ricciolino/smartintercom-OV7670/README.md

# smartintercom-OV7670
IoT project in Smart Home environment: prototype of a smart intercom.
