ricciolino/smartintercom-OV7670/relazione.pdf

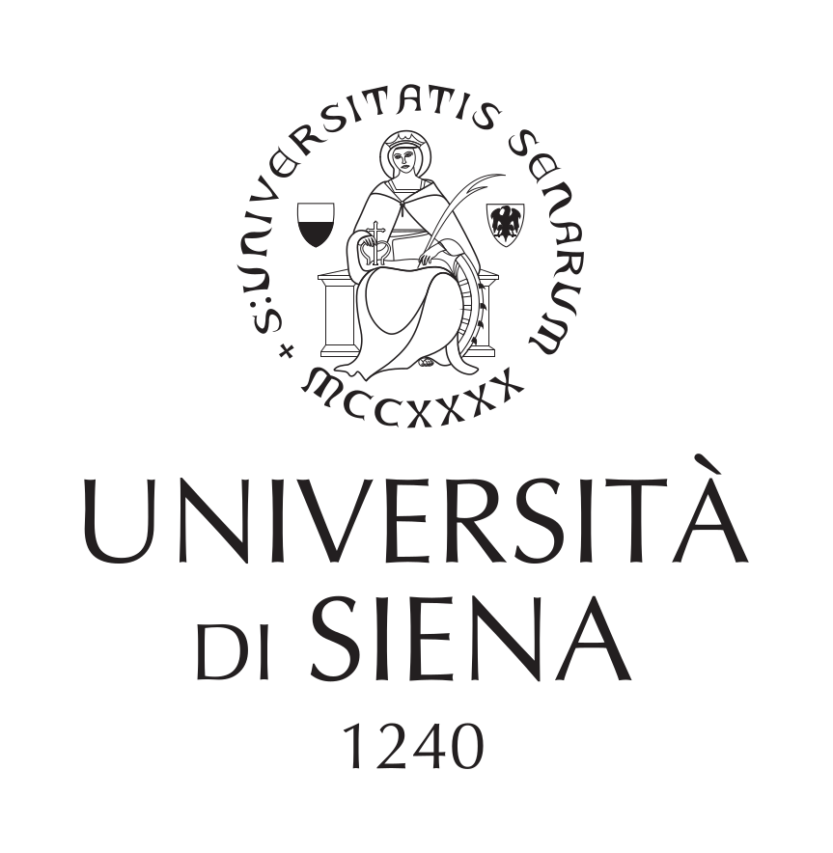
[picture p1: figure]

# Dipartimento di Ingegneria dell’Informazione e Scienze Matematiche

# progetto d’esame:

# Laboratorio di Internet of Things

# CITOFONO CON CAMERA OV7670 ED ESP8266

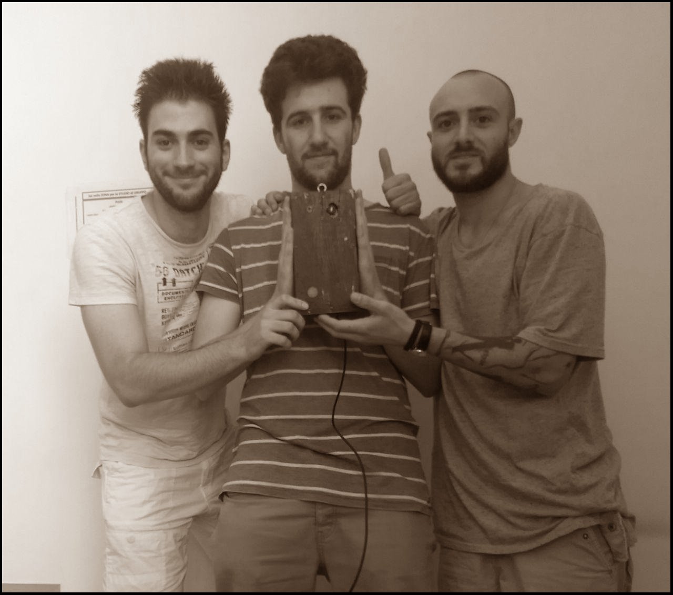
[picture p2: figure]

# A cura di: Lorenzo Moricone, Giovanni Fasino e Nicholas Redi

# lorenzo.moricone@student.unisi.it , gfasino@gmail.com , nicholasredimail@gmail.com

# Anno Accademico 2018-2019

# Indice

- Introduzione | [2]
- Hardware e software utilizzato | [3]
- OV7670 con Arduino UNO | [4]
– Connettere i pezzi | [5]
∗ XCLK | [5]
∗ SIOC e SIOD | [6]
∗ VSYNC, HREF e PCLK | [6]
∗ LED e BOTTONE | [7]
– Lo sketch | [7]

# - ESP8266: comunicazione

seriale ed invio al server | [9]
- Server locale e PHP | [12]
– Channel e BOT Telegram | [12]
– sendphoto.php | [13]
- Conclusioni e possibili sviluppi | [14]
- Codici | [14]
– Arduino UNO | [15]
– ov7670.h | [17]
– ESP8266 | [22]
– initphoto.php | [24]
– dato.php | [24]
– sendphotoAus.php | [25]
– sendphoto.php | [25]
- MEME moments | [26]

1

# Introduzione

# Nel realizzare un progetto IoT in un ambiente Smart Home `e stato deciso di fare un prototipo di un citofono intelligente. Quest’oggetto ha un’applica-

zione abbastanza semplice nel mondo reale quanto utile.

# L’idea di base `e la seguente: la funzione del citofono smart la si attiva quando non si `e in casa, in questo modo qualora qualcuno prema il bottone per suonare il citofono, una fotocamera connessa ad un Arduino gli scatter`a una

foto, che verr`a inviata ad un server locale tramite un modulo Wi-Fi.

# Lato server poi, attraverso le API Telegram disponibili per PHP, si azioner`a un BOT che inoltrer`a la foto su un canale di telegram; gli utenti iscritti a questo canale potranno quindi essere notificati (come per un qualsiasi mes-

saggio) e vedere la foto scattata dal proprio smartphone.

# L’utilit`a dell’oggetto risiede nel fatto di poter sapere da chi siamo cercati

mentre non siamo in casa.

2

# Hardware e software utilizzato

# L’hardware utilizzato per la prototipazione di questo oggetto `e composto da i seguenti elementi:

# - Jumpers

- Breadboard | x1
- Arduino UNO | x1
- ESP8266 | x1
- Camera OV7670 (no FIFO) | x1
- Bottone | x1
- Led | x1
- Resistore 10 kΩ | x2
- Resistore 4.7 kΩ | x2
- Resistore 8.2 kΩ | x1
- Resistore 220 Ω | x1

# Mentre per la parte software `e necessario avere installato e configurato i seguenti servizi¹

:

# - Arduino IDE

# - Apache

# - php

# - php-curl

# 1nota: per la realizzazione dell’intero progetto si suppone di lavorare in ambienti Linux (altri ambienti `e possibile utilizzarli con le dovute accortezze)

| 3

# OV7670 con Arduino UNO

# La prima fase della progettazione riguarda la connessione della camera

con l’Arduino, affinch`e essa sia in grado di trasmettere i dati alla porta sriale.

# Il chip OV7670 `e composto da 18 pin, prevede una tensione di alimentazione di 3.3 V e comunica attraverso il protocollo seriale SCCB (Serial Camera Control Bus), un protocollo seriale proprietario di OmniVision Technologies

Inc. che `e basato sul protollo I2C.
In figura 1 e 2 sono mostrati il chip e la relativa descrizione dei pin.

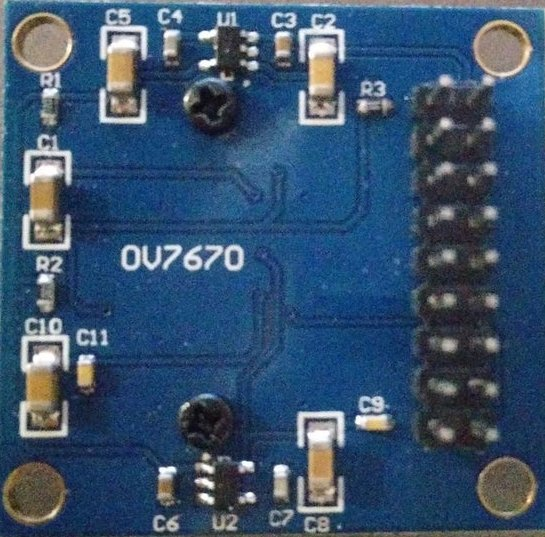
[picture p3: figure]

Figura 1: OV7670 chip.

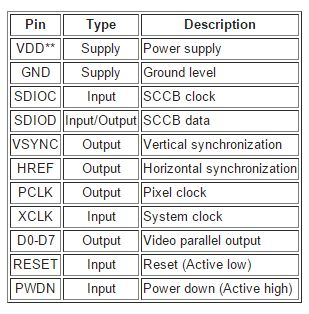
[picture p4: figure]

Figura 2: OV7670 pins description.

Per questo primo interfacciamento si pu`o sfruttare un precedente lavoro² pubblicato da ”ComputerNerd”. Grazie ad esso `e possibile collegare il modulo OV7670 ad Arduino UNO con uno schema ben preciso, ed andare programmare il microcontrollore ATmega328 di Arduino servendosi di una libreria sviluppata ad-hoc. In particolare, tale libreria permette di resettare e impostare (in accordo al datasheet³ ) i registri della fotocamera per acquisire

# 2https://github.com/ComputerNerd/ov7670-no-ram-arduino-uno 3https://www.voti.nl/docs/OV7670.pdf

4

# immagini con risoluzione QVGA (320x240) e codifica del colore YUV422 (in

scala di grigi a 8 bit).

# Connettere i pezzi

Lo schematico prevede i collegamenti mostrati in figura 3.

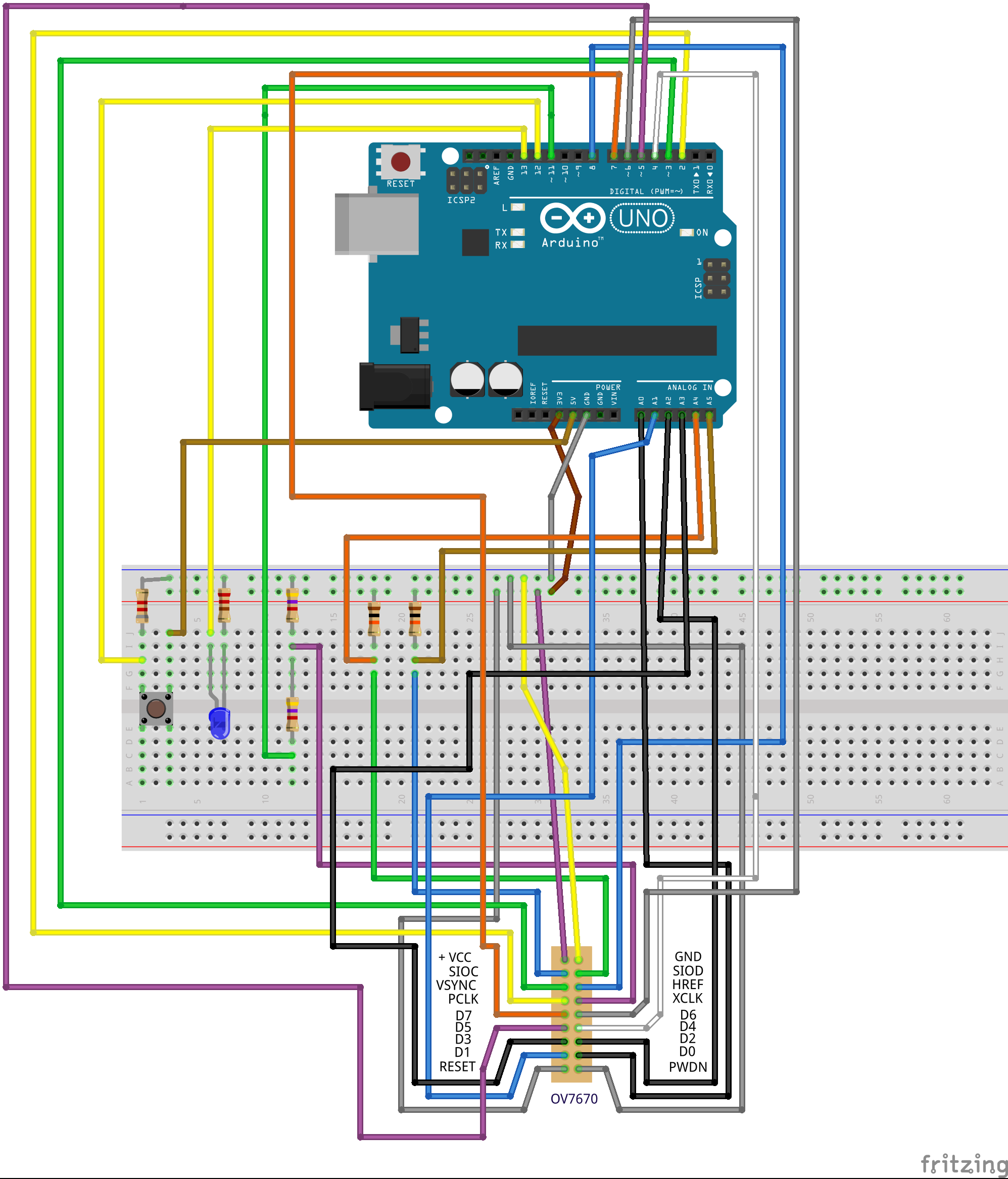
[picture p5: figure]

Figura 3: Connettere Arduino UNO alla fotocamera OV7670.

# XCLK

# Il modulo fotocamera richiede in ingresso un clock di sistema sul pin XCLK. Questo clock `e essenziale per il funzionamento dell’interfaccia SCCB e per qualsiasi altra operazione della fotocamera. Secondo il datasheet, la frequenza su XCLK dovrebbe essere compresa tra 10 e 48 MHz, tuttavia la

5

camera funziona correttamente anche con un clock a 8 MHz.

# Infatti, in questa configurazione, tale clock `e generato con un segnale PWM da 8 MHz dal pin D11 dell’Arduino e, poich`e il chip non sopporta voltaggi superiori ai 3.3 V, `e stato inserito un partitore di tensione per assicurarsi che

il voltaggio in ingresso al modulo OV7670 non superi i 3 V.

# SIOC e SIOD

# Ogni comunicazione seriale I2C `e costituita da due segnali: SCL (Serial Clock) e SDA (Serial Data). Per la fotocamera questi ruoli sono ricoperti

rispettivamente dai pin SIOC e SIOD.

Dato che Arduino lavora a 5 V mentre il modulo OV7670 lavora a 3.3 V, per rendere possibile la comunicazione I2C c’`e bisogno di due resistori di pull-up sul pi`u basso dei due voltaggi (3.3 V). In questa maniera, quando non sono attive le linee SCL e SDA (attive basse), il minimo livello di tensione che ci potr`a essere sar`a 3.3 V, livello che Arduino riconoscer`a come HIGH (e quindi

non attiver`a la linea).

# VSYNC, HREF e PCLK

Il chip invia i dati in un formato sincrono parallelo. Dopo che `e stato applicato un segnale di clock al pin XCLK, la fotocamera inizier`a a pilotare i suoi pin VSYNC, HREF e D0-D7. Il fronte di discesa di VSYNC segnala l’inizio di un frame e il suo fronte di salita segnala la fine. Ogni frame QVGA ha 240 righe e ogni riga ha 320 pixel. Ogni dato di riga deve essere catturato durante lo stato alto di HREF, cio`e D0-D7 devono essere campionati solo quando HREF `e alto. Il fronte di salita di HREF segnala l’inizio di una riga

e il fronte di discesa di HREF segna la fine.
In fugura 4 `e mostrata la temporizzazione.

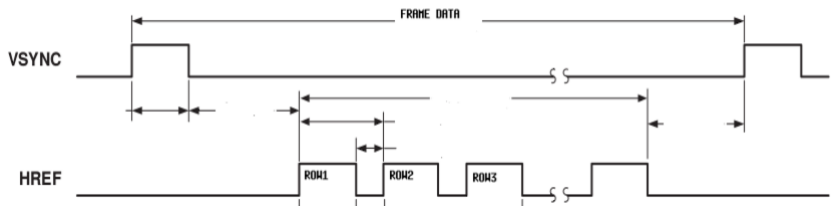
[picture p6: figure]

Figura 4: Temporizzazione durante l’acquisizione di un frame.

# In particolare, D0-D7 devono essere campionati sul fronte di salita del segnale PCLK. La frequenza del segnale PCLK determiner`a quindi, quanto

6

# velocemente vengono acquisiti i byte di una riga (di default PCLK avr`a la

stessa frequenza di XCLK).
In figura 5 sono mostrate le tempistiche da rispettare.

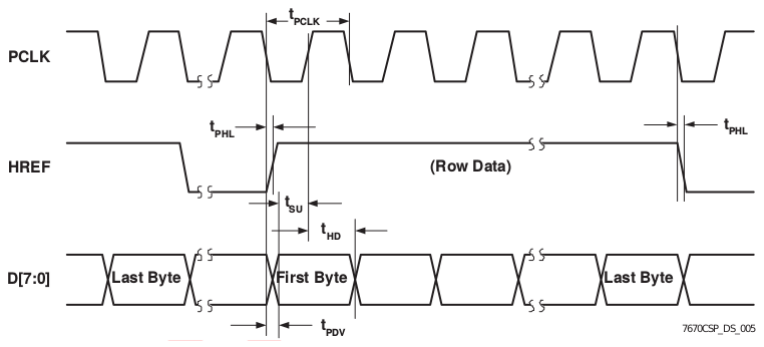
[picture p7: figure]

Figura 5: Temporizzazione durante l’acquisizione di una riga.

# LED e BOTTONE

La logica che sta dietro il led ed il bottone `e molto semplice.

# Il bottone simula il tasto per suonare il citofono, quindi la camera inizier`a

l’acquisizione di un’immagine solo dopo che esso `e stato premuto.

# Il led, invece, lo si pu`o interpretare come un debug visivo: quando il bottone viene schiacciato, il led star`a acceso per 3 secondi, seguir`a un cortissimo blink e torner`a di nuovo acceso, questo segnala l’inizio dell’acquisizione effet-

tiva dell’immagine; per tutto il tempo di acquisizione il led rimarr`a acceso,

# dopodich`e si spenger`a; circa 4 secondi dopo che l’acquisizione `e terminata ci sar`a un cortissimo blink che segnaler`a la possibilit`a di acquisire una nuova

immagine.

# Lo sketch

# Per quanto riguarda la programmazione del microcontrollore ATmega328 `e sufficiente fare l’upload, tramite la IDE Arduino, dello sketch a pagina

14.

# Si pu`o notare come nello sketch `e incluso il file di libreria ”ov7670.h” (il cui codice `e a pagina 16), necessario per l’impostazione di tutti i registri della

fotocamera.

7

# Analizzando il codice dello sketch secondo la logica di Arduino, in fase di setup() si hanno 4 chiamate a funzioni con le seguenti funzionalit`a:

# - arduinoUnoInit() : imposta il segnale di clock per XLCK sul pin 11, imposta la comunicazione con protocollo I2C a 100 kHz ed abilita

la porta seriale con baud rate 1Mbps;

- camInit() : reimposta ai valori predefiniti tutti i registri del chip;
- setRes() : imposta la risoluzione con la quale acquisire l’immagine;
- setColor() : imposta la codifica dei colori;

# successivamente, vengono definiti gli usi dei pin 12 e 13 (rispettivamente per il bottone, INPUT, e per il led, OUTPUT); ed infine si ha un cortissimo blink del led, per segnalare che la fase di setup `e terminata e che la fotocamera `e

pronta per acquisire un’immagine.

Nel loop(), semplicemnete, si usano due variabili (lettura ed old lettura) per controllare lo stato di pressione del pulsante, ed una volta che esso viene premuto, dopo esserci stati i blink descritti prima, si invoca la funzione captureImg(), la quale si occupa della logica di acquisizione dell’immagi-

ne.

La logica di acquisizione funziona cos`ı: viene inviata una sequenza di 5 caratteri ’*’,’R’,’D’,’Y’,’*’ che rappresenta il comando con il quale l’ESP8266 sar`a in grado di sapere qual’`e il primo byte che dovr`a memorizzare come dato dell’immagine, e poi si inizia a ”ciclare” su 240 righe e 320 colonne con le tempistiche definite da VSYNC, HREF e PCLK. I byte da trasmettere alla porta seriale sono preparati sul registro di Arduino UDR0, e

poi trasmessi non appena passa il segnale PCLK.

La cosa di rilievo per questa applicazione, `e che, siccome l’ESP8266 ha una quantit`a di RAM utilizzabile che non supera i 50 kB, si deve effettuare un ritaglio dell’immagine, ottenendo un’immagine 160x120. Utilizzando un byte per pixel (scala di grigio da 0 a 255), si avrebbe un peso dell’immagine in formato QVGA pari a 320 · 240 bytes = 76800 kB e di conseguenza l’ESP non potrebbe ospitarla per intero prima di inviarla, dopo un ritaglio centrale di 160x120 l’immagine peser`a 160 · 120 bytes = 19200 kB, cos`ı l’ESP sar`a in grado di mantenerla in RAM e spezzettarla in pi`u pacchetti per poi inviarla

al server.

8

# ESP8266: comunicazione seriale ed invio al server

# Dopo che l’Arduino `e in grado di acquisire l’immagine e di trasmetterla alla porta seriale correttamente, quello che si deve fare `e collegare il pin TX

di Arduino al pin RX del chip ESP8266.
In figura 6 `e mostrato lo schematico finale.

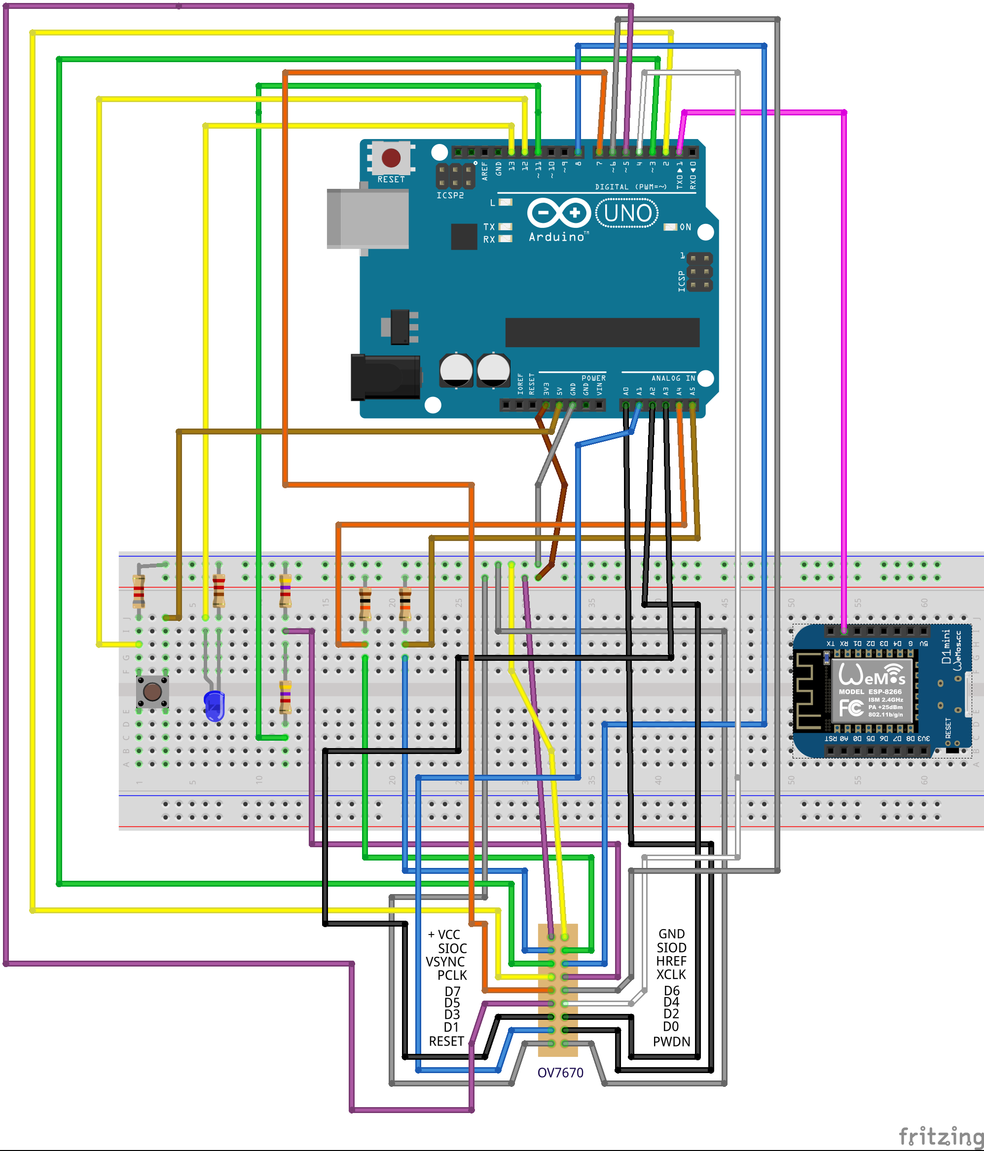
[picture p8: figure]

Figura 6: Schema finale.

# Cos`ı facendo, Arduino UNO abiliter`a la porta seriale in trasmissione verso

l’ESP e, ricordando che il baud rate `e stato impostato da Arduino a 1Mbps,

9

# la comunicazione seriale da attivare lato ESP, dovr`a essere inizializzata alla

stessa frequenza.
Il codice dello sketch per l’ESP `e a pagina 21.

# Nel setup() viene inizializzata la comunicazione seriale a 1 Mbps e creato

l’oggetto WiFiMulti per la connessione alla rete WiFi.

# Nel loop() non si proceder`a oltre il primo controllo, finch`e il modulo ESP non risulter`a connesso alla rete (pu`o richiedere alcuni secondi). Una volta connesso, l’ESP inizier`a a controllare se ci sono dati in arrivo sulla porta se-

riale, cercando di rilevare la sequenza di comando ’*’,’R’,’D’,’Y’,’*’.

Quando sono stati letti i 5 bytes consecutivamente, la variabile photoStarted diventer`a true, e da quel momento, ogni altro byte in arrivo alla seriale sar`a un byte che rappresenta un pixel dell’immagine. E’ importante che i bytes dell’immagine siano letti dall’ESP il pi`u velocemente possibile, cio`e non sono ammesse molte altre operazioni ”fattibili” dall’ESP mentre questo sta leg-

gendo in sequenza i bytes, questo perch`e, essendo il baud rate molto elevato,

ogni altra operazione che farebbe ”perdere tempo” all’ESP rischia di essere abbastanza lunga da far intasare il buffer di comunicazione seriale; ci`o provocherebbe problemi di sincronia tra i due dispositivi e non sarebbe possibile acquisire tutti i bytes dell’immagine correttamente. Inoltre, c’`e da dire che `e proprio questo il motivo per cui l’immagine va ritagliata fino a farla entrare nella RAM dell’ESP: si potrebbe pensare di inviare l’immagine a pezzetti proprio nel mentre si stanno acquisendo i dati dall’Arduino, il fatto `e, che inviare i dati sul web `e un operazione time-consuming, la sincronizzazione sarebbe compromessa. E’ quindi fondamentale riuscere a salvare completa-

mente l’immagine prima di inviarla a pezzetti.

Mentre si acquisiscono i dati dell’immagine, si pu`o notare nel codice, che alcuni livelli di grigio acquisiti dalla fotocamera, vengono manipolati (incrimentati di 1 o di 2); questo `e necessario affinch`e, nell’invio dei pacchetti al server, la stringa che si costruisce come dato del protocollo POST, non sia tagliata involontariamente. Per cui, quando il livello di grigio `e pari a uno dei valori tra 0, 9, 10, 13, 37 e 38 si cambier`a il valore di 1 (2 nel caso di

9 e 37) e la stringa che rappresenter`a il dato del pacchetto da trasmettere,

# non creer`a problemi. Tanto 1 o 2 punti di differenza, in una scala di grigio tra 0 e 255, e, per altro solo in alcuni pixels, non distorceranno la visibilit`a

dell’immagine ad occhio nudo.

Quando il buffer dei dati dell’immagine sar`a riempito ( i == BUFFER SIZE == 19200 ), e quindi l’immagine `e in quel momento salvata comletamente in RAM (in formato grezzo), si passer`a all’invio di essa tramite richieste http al server locale ( http://localhost/PHPIoT/ ). Viene diviso il buffer in sotto-buffer di 2400 bytes e inviati 8 pacchetti con il dato incapsulato sotto forma di stringa. Le operazioni in sequenza, eseguite dal momento che

10

# l’immagine `e salvata, sono le seguenti:

# 1. pulizia del file img.txt (memorizzato nel server) in caso di foto pre-

cedentemente acquisita: chiamata GET al file initphoto.php ;

# 2. invio degli 8 pacchetti da 2400 bytes, appendendoli uno dietro l’altro

al file img.txt, tramite richieste http POST al file dato.php ;

# 3. concatenazione dell’header BMP ( head160x120.bmp ) al file grezzo img.txt per costruire l’immagine finale (apribile con un visualizzatore di foto), ed invio dell’immagine sul canale Telegram: chiamata GET al

file sendphotoAus.php .

Successivamente a queste tre fasi, l’ESP viene resettato per assicurarsi che l’acquisizione di foto successive non occupi tutte le aree di memoria disponibili. Con il reset, i buffer vengono riallocati nuovamente, ed almeno un’acquisizione potr`a sempre andare a buon fine. Il delay() di 4 secondi alla fine del loop() di Arduino UNO `e dovuto proprio a questo tempo, necessario

per l’ESP a resettarsi.

11

# Server locale e PHP

# I codici PHP utilizzati dal server sono visibili tutti nella sezione ”Codici”

a partire da pagina 24.

# Come gi`a detto, la fase di invio dell’ESP si pu`o suddividere in 3 diverse fasi:

la prima fase, riguarda la pulizia del file che deve contenere i dati della foto;

# nella seconda fase, ricorrono pi`u chiamate ad uno stesso file che si occupa di costruire il file dell’immagine grezza; e la terza fase, in cui si costruisce

l’immagine finale e poi la si invia sul canale Telegram.

# La pulizia del file avviene nel file initphoto.php, semplicemente eseguendo da PHP un comando di sistema Linux: se il file img.txt esiste, viene

svuotato (se `e pieno), altrimenti viene creato vuoto.

# Nel file dato.php si estrapola il dato dal metodo POST, ci si assicura che

il file img.txt esista e sia scrivibile, e poi gli si appende la stringa di bytes.

Il file sendphotoAus.php `e solamente un file ausiliario che, tramite un comando di sistema, semplicemente richiama il file sendphoto.php. Questo `e dovuto a ragioni di sicurezza, in quanto `e necessario che il file che si occuper`a di sfruttare le API Telegram per inviare la foto, dovr`a essere chiamato

dal server stesso, e non da fonti esterne.

# Channel e BOT Telegram

# Prima di descrivere il file sendphoto.php `e necessario spiegare cosa va

fatto dall’account Telegram per essere in grado di utilizzare le API in PHP.

# Il primo passo `e quello di creare un BOT sfruttando un’altro BOT messo a disposizione da Telegram con lo username @BotFather. Seguendo le istruzioni di questo BOT sar`a possibile creare un proprio BOT personale. Con la creazione, @BotFather ci fornir`a ache il token del BOT da utilizzare con

le API http.

Poi bisogner`a creare un canale (pubblico) ed aggiungere ad esso il BOT personalmente creato, nel ruolo di amministratore del canale per far si che sia in grado di inviare messaggi. Per recuperare l’ID della chat del canale basta accedere a Telegram Web e cliccare sulla chat del canale, l’ID della chat

12

# `e visibile nell’URL del browser dopo il simbolo @. Dopo aver recuperato l’ID della chat del canale `e possibile impostare il canale come privato, in modo

tale da poter invitare solo le persone interessate.

# sendphoto.php

# La prima operazione in questo file `e quella di finalizzare l’immagine. Lo si fa con due comandi di sistema, che concatenano un header BMP fisso (vedi

pagina 25) con il file img.txt contenente i valori di ogni pixel.

Dopo si costruiscono un p`o di variabili che saranno passate come parametri nel protocollo di invio eseguito tramite il tool curl, un tool che incapsula tutti i parametri necessari per la cumunicazione e la esegue in back-end senza interazione dell’utente. Tra le variabili abbiamo la chat id del canale ed

il bot url con il token del BOT per usarlo tramite le API di Telegram,

# poi si costruisce l’URL completo in cui si specifica quale funzione usare ( sendPhoto?chat id= ), infine, abbiamo un array che associa la foto da

inviare al canale.

# Con il comando curl init() viene istanziata una risorsa cURL, e poi con i comandi set opt vengono impostate tutte le opzioni per la connessione

con i parametri inizializzati.

# Alla fine con curl exec si esegue la risorsa costruita e, salvo errori, l’utente iscritto al canale Telegram, dovrebbe ricevere una notifica di messaggio dal

canale, con la foto scattata.

13

# Conclusioni e possibili sviluppi

Nel realizzare questo progetto ci siamo serviti di componenti estremamente economiche. Andando a valutare il costo complessivo dell’oggetto (10 $ circa, se al posto dell’Arduino UNO sostituiamo la versione standalone: microcontrollore ATmega328, resistore, due condensatori e oscillatore al quarzo), si pu`o affermare che un prototipo del genere `e pi`u che adeguato allo scopo citato nell’introduzione. Se l’obbiettivo `e riconoscere la persona che ha suonato il citofono, questo lo si fa anche con un’immagine, non di eccellente

qualit`a, come la seguente (acquisita direttamente dal prototipo finalizzato).

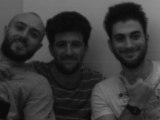
[picture p9: figure]

Figura 7: Immagine acquisita dall’oggetto creato.

# Sarebbe possibile ottenere dei miglioramenti significativi andando a sostituire la fotocamera OV7670 non FIFO con un’altra fotocamera dotata di

buffer interno (FIFO). Questo permetterebbe di rimuovere Arduino UNO,

# che in questo caso funziona come driver della fotocamera, ed il modello FI-FO potrebbe essere collegato direttamente sul chip ESP8266; si avrebbe cos`ı

una semplificazione nell’architettura.

Altra considerazione riguarda la parte del server: si `e usato qui un server esterno per inviare la foto ai server di Telegram, il motivo di ci`o `e dovuto al fatto che, il protocollo HTTP MultipartData (necessario per l’invio segmentato di dati superiori ai 2 kB) non `e implementato nell’ESP8266. Si potrebbe quindi, semplificare ulteriormente l’architettura con un chip ESP pi`u potente e che abbia implementato questo protocollo. Cos`ı facendo, sarebbe rimossa la parte del server esterno e la foto sarebbe inviata su Telegram direttamente

dal chip.

14

# Codici

# Arduino UNO

1 #include <stdint.h>
2 #include <avr/io.h>
3 #include <util/twi.h>
4 #include <util/delay.h>
5 #include <avr/pgmspace.h> 6 #include "ov7670.h"
7
8 void setColor(void) {
9 wrSensorRegs8_8(yuv422_ov7670);
10 }
11
12 void setRes(void) {
13 | wrReg(REG_COM3, 4); // REG_COM3 enable scaling
14 | wrSensorRegs8_8(qvga_ov7670);
15 | wrReg(0x11, 11); // PCLK prescaler
16 }
17
18 void camInit(void) {
19 | wrReg(0x12, 0x80);
20 | _delay_ms(100);
21 | wrSensorRegs8_8(ov7670_default_regs);
22 | wrReg(REG_COM10, 32);//PCLK does not toggle on HBLANK.
23 }
24
25 void arduinoUnoInit(void) {
26 cli();//disable interrupts
27
28 | /* Setup the 8mhz PWM clock
29 | This will be on pin 11*/
30 | DDRB |= (1 << 3);//pin 11
31 | ASSR &= ˜(_BV(EXCLK) | _BV(AS2));
32 | TCCR2A = (1 << COM2A0) | (1 << WGM21) | (1 << WGM20);
33 | TCCR2B = (1 << WGM22) | (1 << CS20);
34 | OCR2A = 0;//(F_CPU)/(2*(X+1))
35 | DDRC &= ˜15;//low d0-d3 camera
36 | DDRD &= ˜252;//d7-d4 and interrupt pins
37 | _delay_ms(3000);
38
39 | //set up twi for 100khz
40 | TWSR &= ˜3;//disable prescaler for TWI
41 | TWBR = 72;//set to 100khz
42
43 | //enable serial
44 | UBRR0H = 0;
45 | UBRR0L = 1;//0 = 2M baud rate. 1 = 1M baud. 3 = 0.5M. 7 = 250k 207 is 9600 baud rate.
46 | UCSR0A |= 2;//double speed aysnc
47 | UCSR0B = (1 << RXEN0) | (1 << TXEN0);//Enable receiver and transmitter
48 | UCSR0C = 6;//async 1 stop bit 8bit char no parity bits
49 }
50
51
52 void StringPgm(const char * str) {
53 | do {
54 | while (!(UCSR0A & (1 << UDRE0)));//wait for byte to transmit
55 | UDR0 = pgm_read_byte_near(str);
56 | while (!(UCSR0A & (1 << UDRE0)));//wait for byte to transmit
57 | } while (pgm_read_byte_near(++str));
58 }
59
60 static void captureImg(){

15

61 uint16_t y, x;
62
63 StringPgm(PSTR("*RDY*"));
64
65 | while (!(PIND & 8));//wait for high
66 | while ((PIND & 8));//wait for low
67
68 | y = 240;
69 | while (y--){
70 | | x = 320;
71 | //while (!(PIND & 256));//wait for high
72 | while (x--){
73 | while ((PIND & 4));//wait for low
74 | if( (y >= 60) && ( y < 180 ) && (x >= 80) && ( x < 240 ) ){
75 | | UDR0 = (PINC & 15) | (PIND & 240);
76 | | while (!(UCSR0A & (1 << UDRE0)));//wait for byte to transmit
77 | }
78 | while (!(PIND & 4));//wait for high
79 | while ((PIND & 4));//wait for low
80 | while (!(PIND & 4));//wait for high
81 | }
82 | // | while ((PIND & 256));//wait for low
83 | }
84 | _delay_ms(100);
85 }
86
87 void setup(){
88 | arduinoUnoInit();
89 | camInit();
90 | setRes();
91 | setColor();
92
93 | pinMode(13, OUTPUT); // led for visual debugging
94 | pinMode(12, INPUT); // simulate the door phone button
95
96 | // a small flash after which the interphone can be played
97 | digitalWrite(13, HIGH);
98 | _delay_ms(200);
99 | digitalWrite(13, LOW);
100 }
101
102
103 int lettura = 0, old_lettura = 0;
104
105 void loop(){
106
107 lettura = digitalRead(12); // read button status
108
109 | // capture the image only if the button come pressed and not if it was remained pressed
110 | if (old_lettura != lettura && old_lettura == 0) {
111
112 | digitalWrite(13, HIGH); // high when the button come pressed, wait 3 seconds
113 | _delay_ms(3000);
114 | digitalWrite(13, LOW); // little blink when the photo starts
115 | _delay_ms(200);
116
117 | digitalWrite(13, HIGH); // led high while capturing
118 | captureImg();
119 | digitalWrite(13, LOW); // led low when finished
120
121 | _delay_ms(4000); // wait 4 seconds before strat a new capturing
122 | digitalWrite(13, HIGH); // little blink to signal that it is possible to start a new capturing
123 | _delay_ms(200);
124 | digitalWrite(13, LOW);
125 | }
126
127 | old_lettura = lettura; // old_lettura remains high until the next time that lettura come back high, double
| | read avoided if the button didn’t come released
128 | delay(200);
129 }

16

# ov7670.h

1 /* Registers */
2 #define REG_GAIN | 0x00 | /* Gain lower 8 bits (rest in vref) */
3 #define REG_BLUE | 0x01 | /* blue gain */
4 #define REG_RED | 0x02 | /* red gain */
5 #define REG_VREF | 0x03 | /* Pieces of GAIN, VSTART, VSTOP */
6 #define REG_COM1 | 0x04 | /* Control 1 */
7 #define COM1_CCIR656 | 0x40 | /* CCIR656 enable */
8 #define REG_BAVE | 0x05 | /* U/B Average level */
9 #define REG_GbAVE | 0x06 | /* Y/Gb Average level */
10 #define REG_AECHH | 0x07 | /* AEC MS 5 bits */
11 #define REG_RAVE | 0x08 | /* V/R Average level */
12 #define REG_COM2 | 0x09 | /* Control 2 */
13 #define COM2_SSLEEP | 0x10 | /* Soft sleep mode */
14 #define REG_PID | 0x0a | /* Product ID MSB */
15 #define REG_VER | 0x0b | /* Product ID LSB */
16 #define REG_COM3 | 0x0c | /* Control 3 */
17 #define COM3_SWAP | 0x40 | /* Byte swap */
18 #define COM3_SCALEEN | 0x08 | /* Enable scaling */
19 #define COM3_DCWEN | 0x04 | /* Enable downsamp/crop/window */
20 #define REG_COM4 | 0x0d | /* Control 4 */
21 #define REG_COM5 | 0x0e | /* All "reserved" */
22 #define REG_COM6 | 0x0f | /* Control 6 */
23 #define REG_AECH | 0x10 | /* More bits of AEC value */
24 #define REG_CLKRC | 0x11 | /* Clocl control */
25 #define CLK_EXT | 0x40 | /* Use external clock directly */
26 #define CLK_SCALE | 0x3f | /* Mask for internal clock scale */
27 #define REG_COM7 | 0x12 | /* Control 7 */ //REG mean address.
28 #define COM7_RESET | 0x80 | /* Register reset */
29 #define COM7_FMT_MASK | 0x38
30 #define COM7_FMT_VGA | 0x00
31 #define COM7_FMT_CIF | 0x20 | /* CIF format */
32 #define COM7_FMT_QVGA | 0x10 | /* QVGA format */
33 #define COM7_FMT_QCIF | 0x08 | /* QCIF format */
34 #define COM7_RGB | 0x04 | /* bits 0 and 2 - RGB format */
35 #define COM7_YUV | 0x00 | /* YUV */
36 #define COM7_BAYER | 0x01 | /* Bayer format */
37 #define COM7_PBAYER | 0x05 | /* "Processed bayer" */
38 #define REG_COM8 | 0x13 | /* Control 8 */
39 #define COM8_FASTAEC | 0x80 | /* Enable fast AGC/AEC */
40 #define COM8_AECSTEP | 0x40 | /* Unlimited AEC step size */
41 #define COM8_BFILT | 0x20 | /* Band filter enable */
42 #define COM8_AGC | 0x04 | /* Auto gain enable */
43 #define COM8_AWB | 0x02 | /* White balance enable */
44 #define COM8_AEC | 0x01 | /* Auto exposure enable */
45 #define REG_COM9 | 0x14 | /* Control 9- gain ceiling */
46 #define REG_COM10 | 0x15 | /* Control 10 */
47 #define COM10_HSYNC | 0x40 | /* HSYNC instead of HREF */
48 #define COM10_PCLK_HB | 0x20 | /* Suppress PCLK on horiz blank */
49 #define COM10_HREF_REV | 0x08 | /* Reverse HREF */
50 #define COM10_VS_LEAD | 0x04 | /* VSYNC on clock leading edge */
51 #define COM10_VS_NEG | 0x02 | /* VSYNC negative */
52 #define COM10_HS_NEG | 0x01 | /* HSYNC negative */
53 #define REG_HSTART | 0x17 | /* Horiz start high bits */
54 #define REG_HSTOP | 0x18 | /* Horiz stop high bits */
55 #define REG_VSTART | 0x19 | /* Vert start high bits */
56 #define REG_VSTOP | 0x1a | /* Vert stop high bits */
57 #define REG_PSHFT | 0x1b | /* Pixel delay after HREF */
58 #define REG_MIDH | 0x1c | /* Manuf. ID high */
59 #define REG_MIDL | 0x1d | /* Manuf. ID low */
60 #define REG_MVFP | 0x1e | /* Mirror / vflip */
61 #define MVFP_MIRROR | 0x20 | /* Mirror image */
62 #define MVFP_FLIP | 0x10 | /* Vertical flip */
63 #define REG_AEW | 0x24 | /* AGC upper limit */
64 #define REG_AEB | 0x25 | /* AGC lower limit */
65 #define REG_VPT | 0x26 | /* AGC/AEC fast mode op region */
66 #define REG_HSYST | 0x30 | /* HSYNC rising edge delay */
67 #define REG_HSYEN | 0x31 | /* HSYNC falling edge delay */
68 #define REG_HREF | 0x32 | /* HREF pieces */
69 #define REG_TSLB | 0x3a | /* lots of stuff */
70 #define TSLB_YLAST | 0x04 | /* UYVY or VYUY - see com13 */
71 #define REG_COM11 | 0x3b | /* Control 11 */
72 #define COM11_NIGHT | 0x80 | /* NIght mode enable */
73 #define COM11_NMFR | 0x60 | /* Two bit NM frame rate */
74 #define COM11_HZAUTO | 0x10 | /* Auto detect 50/60 Hz */
75 #define COM11_50HZ | 0x08 | /* Manual 50Hz select */
76 #define COM11_EXP | 0x02
77 #define REG_COM12 | 0x3c | /* Control 12 */
78 #define COM12_HREF | 0x80 | /* HREF always */
79 #define REG_COM13 | 0x3d | /* Control 13 */
80 #define COM13_GAMMA | 0x80 | /* Gamma enable */
81 #define COM13_UVSAT | 0x40 | /* UV saturation auto adjustment */

17

82 #define COM13_UVSWAP | 0x01 | /* V before U - w/TSLB */
83 #define REG_COM14 | 0x3e | /* Control 14 */
84 #define COM14_DCWEN | 0x10 | /* DCW/PCLK-scale enable */
85 #define REG_EDGE | 0x3f | /* Edge enhancement factor */
86 #define REG_COM15 | 0x40 | /* Control 15 */
87 #define COM15_R10F0 | 0x00 | /* Data range 10 to F0 */
88 #define COM15_R01FE | 0x80 | /* | 01 to FE */
89 #define COM15_R00FF | 0xc0 | /* | 00 to FF */
90 #define COM15_RGB565 | 0x10 | /* RGB565 output */
91 #define COM15_RGB555 | 0x30 | /* RGB555 output */
92 #define REG_COM16 | 0x41 | /* Control 16 */
93 #define COM16_AWBGAIN | 0x08 | /* AWB gain enable */
94 #define REG_COM17 | 0x42 | /* Control 17 */
95 #define COM17_AECWIN | 0xc0 | /* AEC window - must match COM4 */
96 #define COM17_CBAR | 0x08 | /* DSP Color bar */
97 /*
98 | This matrix defines how the colors are generated, must be
99 | tweaked to adjust hue and saturation.
100
101 | Order: v-red, v-green, v-blue, u-red, u-green, u-blue
102 | They are nine-bit signed quantities, with the sign bit
103 | stored in0x58.Sign for v-red is bit 0, and up from there.
104 */
105 #define REG_CMATRIX_BASE | 0x4f
106 #define CMATRIX_LEN | 6
107 #define REG_CMATRIX_SIGN | 0x58
108 #define REG_BRIGHT | 0x55 | /* Brightness */
109 #define REG_CONTRAS | 0x56 | /* Contrast control */
110 #define REG_GFIX | 0x69 | /* Fix gain control */
111 #define REG_REG76 | 0x76 | /* OV’s name */
112 #define R76_BLKPCOR | 0x80 | /* Black pixel correction enable */
113 #define R76_WHTPCOR | 0x40 | /* White pixel correction enable */
114 #define REG_RGB444 | 0x8c | /* RGB 444 control */
115 #define R444_ENABLE | 0x02 | /* Turn on RGB444, overrides 5x5 */
116 #define R444_RGBX | 0x01 | /* Empty nibble at end */
117 #define REG_BD50MAX | 0xa5 | /* 50hz banding step limit */
118 #define REG_BD60MAX | 0xab | /* 60hz banding step limit */
119 #define REG_RED | 0x02 | /* red gain */
120 #define COM1_CCIR656 | 0x40 | /* CCIR656 enable */
121 #define COM7_RGB | 0x04 | /* bits 0 and 2 - RGB format */
122 #define COM7_YUV | 0x00 | /* YUV */
123 #define COM10_VS_LEAD | | 0x04 | /* VSYNC on clock leading edge */
124 #define REG_AEB | 0x25 | /* AGC lower limit */
125 #define CMATRIX_LEN | 6
126 #define REG_HAECC1 | 0x9f | /* Hist AEC/AGC control 1 */
127 #define REG_HAECC2 | 0xa0 | /* Hist AEC/AGC control 2 */
128 #define REG_HAECC3 | 0xa6 | /* Hist AEC/AGC control 3 */
129 #define REG_HAECC4 | 0xa7 | /* Hist AEC/AGC control 4 */
130 #define REG_HAECC5 | 0xa8 | /* Hist AEC/AGC control 5 */
131 #define REG_HAECC6 | 0xa9 | /* Hist AEC/AGC control 6 */
132 #define REG_HAECC7 | 0xaa | /* Hist AEC/AGC control 7 */
133 #define MTX1 | 0x4f | /* Matrix Coefficient 1 */
134 #define MTX2 | 0x50 | /* Matrix Coefficient 2 */
135 #define MTX3 | 0x51 | /* Matrix Coefficient 3 */
136 #define MTX4 | 0x52 | /* Matrix Coefficient 4 */
137 #define MTX5 | 0x53 | /* Matrix Coefficient 5 */
138 #define MTX6 | 0x54 | /* Matrix Coefficient 6 */
139 #define MTXS | 0x58 | /* Matrix Coefficient Sign */
140 #define AWBC7 | 0x59 | /* AWB Control 7 */
141 #define AWBC8 | 0x5a | /* AWB Control 8 */
142 #define AWBC9 | 0x5b | /* AWB Control 9 */
143 #define AWBC10 | 0x5c | /* AWB Control 10 */
144 #define AWBC11 | 0x5d | /* AWB Control 11 */
145 #define AWBC12 | 0x5e | /* AWB Control 12 */
146 #define REG_GFI | 0x69 | /* Fix gain control */
147 #define GGAIN | 0x6a | /* G Channel AWB Gain */
148 #define DBLV | 0x6b
149 #define AWBCTR3 | 0x6c | /* AWB Control 3 */
150 #define AWBCTR2 | 0x6d | /* AWB Control 2 */
151 #define AWBCTR1 | 0x6e | /* AWB Control 1 */
152 #define AWBCTR0 | 0x6f | /* AWB Control 0 */
153
154 struct regval_list {
155 | uint8_t reg_num;
156 | uint16_t value;
157 };
158
159 const struct regval_list qvga_ov7670[] PROGMEM = {
160 | { REG_COM14, 0x19 },
161 | { 0x72, 0x11 },
162 | { 0x73, 0xf1 },
163
164 { REG_HSTART, 0x16 },

18

165 | { REG_HSTOP, 0x04 },
166 | { REG_HREF, 0xa4 },
167 | { REG_VSTART, 0x02 },
168 | { REG_VSTOP, 0x7a },
169 | { REG_VREF, 0x0a },
170
171
172 /* | { REG_HSTART, 0x16 },
173 | { REG_HSTOP, 0x04 },
174 | { REG_HREF, 0x24 },
175 | { REG_VSTART, 0x02 },
176 | { REG_VSTOP, 0x7a },
177 | { REG_VREF, 0x0a },*/
178 | { 0xff, 0xff }, /* END MARKER */
179 };
180
181 const struct regval_list yuv422_ov7670[] PROGMEM = {
182 | { REG_COM7, 0x0 }, | /* Selects YUV mode */
183 | { REG_RGB444, 0 }, | /* No RGB444 please */
184 | { REG_COM1, 0 },
185 | { REG_COM15, COM15_R00FF },
186 | { REG_COM9, 0x6A }, /* 128x gain ceiling; 0x8 is reserved bit */
187 | { 0x4f, 0x80 }, | /* "matrix coefficient 1" */
188 | { 0x50, 0x80 }, | /* "matrix coefficient 2" */
189 | { 0x51, 0 }, | /* vb */
190 | { 0x52, 0x22 }, | /* "matrix coefficient 4" */
191 | { 0x53, 0x5e }, | /* "matrix coefficient 5" */
192 | { 0x54, 0x80 }, | /* "matrix coefficient 6" */
193 | { REG_COM13, COM13_UVSAT },
194 | { 0xff, 0xff }, | /* END MARKER */
195 };
196
197 const struct regval_list ov7670_default_regs[] PROGMEM = {//from the linux driver
198 | { REG_COM7, COM7_RESET },
199 | { REG_TSLB, 0x04 }, /* OV */
200 | { REG_COM7, 0 }, | /* VGA */
201 | /*
202 | Set the hardware window. | These values from OV don’t entirely
203 | make sense - hstop is less than hstart. | But they work...
204 | */
205 | { REG_HSTART, 0x13 }, { REG_HSTOP, 0x01 },
206 | { REG_HREF, 0xb6 }, { REG_VSTART, 0x02 },
207 | { REG_VSTOP, 0x7a }, { REG_VREF, 0x0a },
208
209 | { REG_COM3, 0 }, { REG_COM14, 0 },
210 | /* Mystery scaling numbers */
211 | { 0x70, 0x3a }, { 0x71, 0x35 },
212 | { 0x72, 0x11 }, { 0x73, 0xf0 },
213 | { 0xa2,/* 0x02 changed to 1*/1 }, { REG_COM10, 0x0 },
214 | /* Gamma curve values */
215 | { 0x7a, 0x20 }, { 0x7b, 0x10 },
216 | { 0x7c, 0x1e }, { 0x7d, 0x35 },
217 | { 0x7e, 0x5a }, { 0x7f, 0x69 },
218 | { 0x80, 0x76 }, { 0x81, 0x80 },
219 | { 0x82, 0x88 }, { 0x83, 0x8f },
220 | { 0x84, 0x96 }, { 0x85, 0xa3 },
221 | { 0x86, 0xaf }, { 0x87, 0xc4 },
222 | { 0x88, 0xd7 }, { 0x89, 0xe8 },
223 | /* AGC and AEC parameters. | Note we start by disabling those features,
224 | then turn them only after tweaking the values. */
225 | { REG_COM8, COM8_FASTAEC | COM8_AECSTEP },
226 | { REG_GAIN, 0 }, { REG_AECH, 0 },
227 | { REG_COM4, 0x40 }, /* magic reserved bit */
228 | { REG_COM9, 0x18 }, /* 4x gain + magic rsvd bit */
229 | { REG_BD50MAX, 0x05 }, { REG_BD60MAX, 0x07 },
230 | { REG_AEW, 0x95 }, { REG_AEB, 0x33 },
231 | { REG_VPT, 0xe3 }, { REG_HAECC1, 0x78 },
232 | { REG_HAECC2, 0x68 }, { 0xa1, 0x03 }, /* magic */
233 | { REG_HAECC3, 0xd8 }, { REG_HAECC4, 0xd8 },
234 | { REG_HAECC5, 0xf0 }, { REG_HAECC6, 0x90 },
235 | { REG_HAECC7, 0x94 },
236 | { REG_COM8, COM8_FASTAEC | COM8_AECSTEP | COM8_AGC | COM8_AEC },
237 | { 0x30, 0 }, { 0x31, 0 },//disable some delays
238 | /* Almost all of these are magic "reserved" values. | */
239 | { REG_COM5, 0x61 }, { REG_COM6, 0x4b },
240 | { 0x16, 0x02 }, { REG_MVFP, 0x07 },
241 | { 0x21, 0x02 }, { 0x22, 0x91 },
242 | { 0x29, 0x07 }, { 0x33, 0x0b },
243 | { 0x35, 0x0b }, { 0x37, 0x1d },
244 | { 0x38, 0x71 }, { 0x39, 0x2a },
245 | { REG_COM12, 0x78 }, { 0x4d, 0x40 },
246 | { 0x4e, 0x20 }, { REG_GFIX, 0 },
247 | /*{0x6b, 0x4a},*/{ 0x74, 0x10 },

19

248 | { 0x8d, 0x4f }, { 0x8e, 0 },
249 | { 0x8f, 0 }, { 0x90, 0 },
250 | { 0x91, 0 }, { 0x96, 0 },
251 | { 0x9a, 0 }, { 0xb0, 0x84 },
252 | { 0xb1, 0x0c }, { 0xb2, 0x0e },
253 | { 0xb3, 0x82 }, { 0xb8, 0x0a },
254
255 | /* More reserved magic, some of which tweaks white balance */
256 | { 0x43, 0x0a }, { 0x44, 0xf0 },
257 | { 0x45, 0x34 }, { 0x46, 0x58 },
258 | { 0x47, 0x28 }, { 0x48, 0x3a },
259 | { 0x59, 0x88 }, { 0x5a, 0x88 },
260 | { 0x5b, 0x44 }, { 0x5c, 0x67 },
261 | { 0x5d, 0x49 }, { 0x5e, 0x0e },
262 | { 0x6c, 0x0a }, { 0x6d, 0x55 },
263 | { 0x6e, 0x11 }, { 0x6f, 0x9e }, /* it was 0x9F "9e for advance AWB" */
264 | { 0x6a, 0x40 }, { REG_BLUE, 0x40 },
265 | { REG_RED, 0x60 },
266 | { REG_COM8, COM8_FASTAEC | COM8_AECSTEP | COM8_AGC | COM8_AEC | COM8_AWB },
267
268 | /* Matrix coefficients */
269 | { 0x4f, 0x80 }, { 0x50, 0x80 },
270 | { 0x51, 0 }, | { 0x52, 0x22 },
271 | { 0x53, 0x5e }, { 0x54, 0x80 },
272 | { 0x58, 0x9e },
273
274 | { REG_COM16, COM16_AWBGAIN }, { REG_EDGE, 0 },
275 | { 0x75, 0x05 }, { REG_REG76, 0xe1 },
276 | { 0x4c, 0 }, | { 0x77, 0x01 },
277 | { REG_COM13, /*0xc3*/0x48 }, { 0x4b, 0x09 },
278 | { 0xc9, 0x60 }, | /*{REG_COM16, 0x38},*/
279 | { 0x56, 0x40 },
280
281 | { 0x34, 0x11 }, { REG_COM11, COM11_EXP | COM11_HZAUTO },
282 | { 0xa4, 0x82/*Was 0x88*/ }, { 0x96, 0 },
283 | { 0x97, 0x30 }, { 0x98, 0x20 },
284 | { 0x99, 0x30 }, { 0x9a, 0x84 },
285 | { 0x9b, 0x29 }, { 0x9c, 0x03 },
286 | { 0x9d, 0x4c }, { 0x9e, 0x3f },
287 | { 0x78, 0x04 },
288
289 | /* Extra-weird stuff. | Some sort of multiplexor register */
290 | { 0x79, 0x01 }, { 0xc8, 0xf0 },
291 | { 0x79, 0x0f }, { 0xc8, 0x00 },
292 | { 0x79, 0x10 }, { 0xc8, 0x7e },
293 | { 0x79, 0x0a }, { 0xc8, 0x80 },
294 | { 0x79, 0x0b }, { 0xc8, 0x01 },
295 | { 0x79, 0x0c }, { 0xc8, 0x0f },
296 | { 0x79, 0x0d }, { 0xc8, 0x20 },
297 | { 0x79, 0x09 }, { 0xc8, 0x80 },
298 | { 0x79, 0x02 }, { 0xc8, 0xc0 },
299 | { 0x79, 0x03 }, { 0xc8, 0x40 },
300 | { 0x79, 0x05 }, { 0xc8, 0x30 },
301 | { 0x79, 0x26 },
302 | { 0xff, 0xff }, /* END MARKER */
303 };
304
305
306 void error_led(void) {
307 | DDRB |= 32;//make sure led is output
308 | while (1) { //wait for reset
309 | PORTB ˆ= 32;// toggle led
310 | _delay_ms(100);
311 | }
312 }
313
314 void twiStart(void) {
315 | TWCR = _BV(TWINT) | _BV(TWSTA) | _BV(TWEN);//send start
316 | while (!(TWCR & (1 << TWINT)));//wait for start to be transmitted
317 | if ((TWSR & 0xF8) != TW_START)
318 | error_led();
319 }
320
321 void twiWriteByte(uint8_t DATA, uint8_t type) {
322 | TWDR = DATA;
323 | TWCR = _BV(TWINT) | _BV(TWEN);
324 | while (!(TWCR & (1 << TWINT))) {}
325 | if ((TWSR & 0xF8) != type)
326 | error_led();
327 }
328
329 void twiAddr(uint8_t addr, uint8_t typeTWI) { 330 TWDR = addr;//send address

20

331 | TWCR = _BV(TWINT) | _BV(TWEN); | /* clear interrupt to start transmission */
332 | while ((TWCR & _BV(TWINT)) == 0); /* wait for transmission */
333 | if ((TWSR & 0xF8) != typeTWI)
334 | error_led();
335 }
336
337 void wrReg(uint8_t reg, uint8_t dat) {
338 | //send start condition
339 | twiStart();
340 | twiAddr(0x42, TW_MT_SLA_ACK);
341 | twiWriteByte(reg, TW_MT_DATA_ACK);
342 | twiWriteByte(dat, TW_MT_DATA_ACK);
343 | TWCR = (1 << TWINT) | (1 << TWEN) | (1 << TWSTO);//send stop
344 | _delay_ms(1);
345 }
346
347 void wrSensorRegs8_8(const struct regval_list reglist[]) {
348 | uint8_t reg_addr, reg_val;
349 | const struct regval_list *next = reglist;
350 | while ((reg_addr != 0xff) | (reg_val != 0xff)) {
351 | reg_addr = pgm_read_byte(&next->reg_num);
352 | reg_val = pgm_read_byte(&next->value);
353 | wrReg(reg_addr, reg_val);
354 | next++;
355 | }
356 }

21

# ESP8266

1 #include <ESP8266WiFiMulti.h> // for connect to Wi-Fi 2 #include <ESP8266HTTPClient.h> // for the http requests
3
4 // the object through which the ESP connect its to Wi-Fi 5 ESP8266WiFiMulti WiFiMulti;
6
7 // buffer and sub-buffer
8 #define BUFFER_SIZE 19200
9 #define SUB_BUFFER_SIZE 2400
10 #define N_PACKETS BUFFER_SIZE/SUB_BUFFER_SIZE 11 char buf[BUFFER_SIZE];
12 char subBuf[SUB_BUFFER_SIZE + 1];
13
14 int i = 0; // index of buffer
15
16 HTTPClient http; // the object for the http requests
17
18 bool photoStarted = false; // become true while capturing the photo
19
20 // constants Wi-Fi connection
21 const char server[] = "10.101.130.120";
22 const char ssid[] = "UnisiConference";
23 const char psw[] = "squatuests";
24
25 // function to check the success of the http requests 26 bool http_code_ok(int httpcode) {
27 | if (httpcode > 0) {
28 | if (httpcode != HTTP_CODE_OK) {
29 | Serial.write("httpcode != HTTP_CODE_OK");
30 | Serial.write(’\n’);
31 | return false;
32 | }
33 | }
34 | else {
35 | Serial.write("httpcode <= 0 : ERROR");
36 | Serial.write(’\n’);
37 | return false;
38 | }
39 | return true;
40 }
41
42 void setup() {
43 | Serial.begin(1000000); // setup the baud rate to 1Mbps
44 | WiFiMulti.addAP(ssid, psw); // initialize the Wi-Fi object and wait for connection
45 | Serial.write("connecting...");
46 }
47
48 void loop() {
49 | // do nothing while the ESP is not connected
50 | if ((WiFiMulti.run() != WL_CONNECTED)) {
51 | Serial.write(’.’);
52 | return;
53 | }
54
55 | // wait for bytes into the serial lines
56 | while (Serial.available() > 0) {
57 | if (!photoStarted) { // wait for the command sequence
58 | if (Serial.read() == ’*’) {
59 | Serial.write("*");
60 | if (Serial.read() == ’R’) {
61 | Serial.write("R");
62 | if (Serial.read() == ’D’) {
63 | Serial.write("D");
64 | if (Serial.read() == ’Y’) {
65 | Serial.write("Y");
66 | if (Serial.read() == ’*’) {
67 | photoStarted = true;
68 | Serial.write("*\n");
69 | Serial.write("Capturing started...");
70 | Serial.write(’\n’);
71 | }
72 | }
73 | }
74 | }
75 | }
76 | }
77 | else { // capturing started, buffer filling
78 | buf[i] = Serial.read();
79 | // some bytes give problem while converting into String objects for the http requests, then some pixel
| values will be increased by 1 or 2 (doesn’t compromise the image quality)
80 | if (buf[i] == 0 || buf[i] == 9 || buf[i] == 13 || buf[i] == 37)

22

81 | buf[i] = buf[i] + 1;
82 | if (buf[i] == 10 || buf[i] == 38)
83 | buf[i] = buf[i] + 1;
84 | i++; // increase index
85 | }
86 | }
87
88 | // once the buffer is full, start trasmission
89 | if (i == BUFFER_SIZE) {
90 | Serial.write("Capturing finished.");
91 | Serial.write(’\n’);
92
93 | // clear the file test.txt
94 | http.begin("http://" + String(server) + "/PHPIoT/initphoto.php");
95 | if (!http_code_ok(http.GET())) {
96 | i = 0;
97 | Serial.write("Photo not uploaded.");
98 | Serial.write(’\n’);
99 | Serial.write("error during the GET to initphoto.php");
100 | Serial.write(’\n’);
101 | http.end();
102 | return;
103 | }
104 | http.end();
105
106 | // start to uploading splitting the buffer in packets of 300 bytes
107 | Serial.write("Uploading to localhost...");
108 | Serial.write(’\n’);
109 | for (int j = 0; j < N_PACKETS; j++) {
110 | // extrapolate the packet with memcpy
111 | memcpy(subBuf, buf + j * SUB_BUFFER_SIZE, SUB_BUFFER_SIZE);
112 | subBuf[SUB_BUFFER_SIZE] = ’\0’; // end of String
113 | String message = "dato=" + String(subBuf);
114 | http.begin("http://" + String(server) + "/PHPIoT/dato.php");
115 | http.addHeader("Content-Type", "application/x-www-form-urlencoded");
116 | if (!http_code_ok(http.POST(message))) {
117 | i = 0;
118 | Serial.write("Photo not uploaded.");
119 | Serial.write(’\n’);
120 | Serial.write("error during the POST of packet ");
121 | Serial.print(j + 1);
122 | Serial.write(’\n’);
123 | http.end();
124 | return;
125 | }
126 | http.end();
127 | }
128 | Serial.write("uploaded.");
129 | Serial.write(’\n’);
130
131 | // after the photo is been uploaded, send it with Telegram BOT
132 | http.begin("http://" + String(server) + "/PHPIoT/sendphotoAus.php");
133 | if (!http_code_ok(http.GET())) {
134 | i = 0;
135 | Serial.write("Photo not sent.");
136 | Serial.write(’\n’);
137 | Serial.write("error during the GET to sendphotoAus.php");
138 | Serial.write(’\n’);
139 | http.end();
140 | return;
141 | }
142 | http.end();
143
144 | // after the photo is been sent it is possible to start a new capturing
145 | Serial.write("Press the button to start a new capturing...");
146 | Serial.write(’\n’);
147 | Serial.write(’\n’);
148 | photoStarted = false;
149 | i = 0;
150 | ESP.reset();
151 | }
152 }

23

# initphoto.php

# <?php

echo system(" > img.txt", $res); ?>

# dato.php

# <?php

$filename = ’img.txt’;
$dato = $_POST[’dato’];

set_time_limit(5*60);
// Let’s make sure the file exists and is writable first.

# if (is_writable($filename)) { if (!$handle = fopen($filename, ’a’)) {

echo "Cannot open file ($filename)"; exit;
}

// Write $dato to our opened file.

# if (fwrite($handle, $dato) === FALSE) {

echo "Cannot write to file ($filename)"; exit;
}

fclose($handle);

# } else {

echo "The file $filename is not writable"; }
?>

# sendphotoAus.php

# <?php

system("php sendphoto.php", $res); ?>

# sendphoto.php

# <?php #create final bmp

system("cat head160x120.bmp > final160x120.bmp", $res);

24 system("cat img.txt >> final160x120.bmp", $res);

$chat_id="@ov7670_ricciolino";
$bot_url = "https://api.telegram.org/bot" . $your_bot_token . "/"; $url = $bot_url . "sendPhoto?chat_id=" . $chat_id;

# $post_fields = array(

’chat_id’ => $chat_id ,

# ’photo’ => new CURLFile(realpath("final160x120.bmp"))

);

$ch = curl_init();
curl_setopt($ch, CURLOPT_HTTPHEADER,

# array( "Content-Type:multipart/form-data" )

);
curl_setopt($ch, CURLOPT_URL, $url); curl_setopt($ch, CURLOPT_RETURNTRANSFER, 1); curl_setopt($ch, CURLOPT_POSTFIELDS, $post_fields); $output = curl_exec($ch);
?>

# head160x120.bmp

# Per quanto riguarda il file header da concatenare al file img.txt, basta incollare i seguenti byte in un editor esadecimale (per esempio Bless Hex Editor) e salvare il file come head160x120.bmp :

42 4D 7A 4F 00 00 00 00 00 00 7A 04 00 00 6C 00 00 00 A0 00 00 00 78 00 00 00 01 00 08 00 00 00 00 00 00 4B 00 00 13 0B 00 00 13 0B 00 00 00 01 00 00 00 01 00 00 42 47 52 73 00 00 00 00 00 00 00 00 00 00 00 00 00 00 00 00 00 00 00 00 00 00 00 00 00 00 00 00 00 00 00 00 00 00 00 00 00 00 00 00 00 00 00 00 00 00 00 00 02 00 00 00 00 00 00 00 00 00 00 00 00 00 00 00 00 00 00 00 01 01 01 00 02 02 02 00 03 03 03 00 04 04 04 00 05 05 05 00 06 06 06 00 07 07 07 00 08 08 08 00 09 09 09 00 0A 0A 0A 00 0B 0B 0B 00 0C 0C 0C 00 0D 0D 0D 00 0E 0E 0E 00 0F 0F 0F 00 10 10 10 00 11 11 11 00 12 12 12 00 13 13 13 00 14 14 14 00 15 15 15 00 16 16 16 00 17 17 17 00 18 18 18 00 19 19 19 00 1A 1A 1A 00 1B 1B 1B 00 1C 1C 1C 00 1D 1D 1D 00 1E 1E 1E 00 1F 1F 1F 00 20 20 20 00 21 21 21 00 22 22 22 00 23 23 23 00 24 24 24 00 25 25 25 00 26 26 26 00 27 27 27 00 28 28 28 00 29 29 29 00 2A 2A 2A 00 2B 2B 2B 00 2C 2C 2C 00 2D 2D 2D 00 2E 2E 2E 00 2F 2F 2F 00 30 30 30 00 31 31 31 00 32 32 32 00 33 33 33 00 34 34 34 00 35 35 35 00 36 36 36 00 37 37 37 00 38 38 38 00 39 39 39 00 3A 3A 3A 00 3B 3B 3B 00 3C 3C 3C 00 3D 3D 3D 00 3E 3E 3E 00 3F 3F 3F 00 40 40 40 00 41 41 41 00 42 42 42 00 43 43 43 00 44 44 44 00 45 45 45 00 46 46 46 00 47 47 47 00 48 48 48 00 49 49 49 00 4A 4A 4A 00 4B 4B 4B 00 4C 4C 4C 00 4D 4D 4D 00 4E 4E 4E 00 4F 4F 4F 00 50 50 50 00 51 51 51 00 52 52 52 00 53 53 53 00 54 54 54 00 55 55 55 00 56 56 56 00 57 57 57 00 58 58 58 00 59 59 59 00 5A 5A 5A 00 5B 5B 5B 00 5C 5C 5C 00 5D 5D 5D 00 5E 5E 5E 00 5F 5F 5F 00 60 60 60 00 61 61 61 00 62 62 62 00 63 63 63 00 64 64 64 00 65 65 65 00 66 66 66 00 67 67 67 00 68 68 68 00 69 69 69 00 6A 6A 6A 00 6B 6B 6B 00 6C 6C 6C 00 6D 6D 6D 00 6E 6E 6E 00 6F 6F 6F 00 70 70 70 00 71 71 71 00 72 72 72 00 73 73 73 00 74 74 74 00 75 75 75 00 76 76 76 00 77 77 77 00 78 78 78 00 79 79 79 00 7A 7A 7A 00 7B 7B 7B 00 7C 7C 7C 00 7D 7D 7D 00 7E 7E 7E 00 7F 7F 7F 00 80 80 80 00 81 81 81 00 82 82 82 00 83 83 83 00 84 84 84 00 85 85 85 00 86 86 86 00 87 87 87 00 88 88 88 00 89 89 89 00 8A 8A 8A 00 8B 8B 8B 00 8C 8C 8C 00 8D 8D 8D 00 8E 8E 8E 00 8F 8F 8F 00 90 90 90 00 91 91 91 00 92 92 92 00 93 93 93 00 94 94 94 00 95 95 95 00 96 96 96 00 97 97 97 00 98 98 98 00 99 99 99 00 9A 9A 9A 00 9B 9B 9B 00 9C 9C 9C 00 9D 9D 9D 00 9E 9E 9E 00 9F 9F 9F 00 A0 A0 A0 00 A1 A1 A1 00 A2 A2 A2 00 A3 A3 A3 00 A4 A4 A4 00 A5 A5 A5 00 A6 A6 A6 00 A7 A7 A7 00 A8 A8 A8 00 A9 A9 A9 00 AA AA AA 00 AB AB AB 00 AC AC AC 00 AD AD AD 00 AE AE AE 00 AF AF AF 00 B0 B0 B0 00 B1 B1 B1 00 B2 B2 B2 00 B3 B3 B3 00 B4 B4 B4 00 B5 B5 B5 00 B6 B6 B6 00 B7 B7 B7 00 B8 B8 B8 00 B9 B9 B9 00 BA BA BA 00 BB BB BB 00 BC BC BC 00 BD BD BD 00 BE BE BE 00 BF BF BF 00 C0 C0 C0 00 C1 C1 C1 00 C2 C2 C2 00 C3 C3 C3 00 C4 C4 C4 00 C5 C5 C5 00 C6 C6 C6 00 C7 C7 C7 00 C8 C8 C8 00 C9 C9 C9 00 CA CA CA 00 CB CB CB 00 CC CC CC 00 CD CD CD 00 CE CE CE 00 CF CF CF 00 D0 D0 D0 00 D1 D1 D1 00 D2 D2 D2 00 D3 D3 D3 00 D4 D4 D4 00 D5 D5 D5 00 D6 D6 D6 00 D7 D7 D7 00 D8 D8 D8 00 D9 D9 D9 00 DA DA DA 00 DB DB DB 00 DC DC DC 00 DD DD DD 00 DE DE DE 00 DF DF DF 00 E0 E0 E0 00 E1 E1 E1 00 E2 E2 E2 00 E3 E3 E3 00 E4 E4 E4 00 E5 E5 E5 00 E6 E6 E6 00 E7 E7 E7 00 E8 E8 E8 00 E9 E9 E9 00 EA EA EA 00 EB EB EB 00 EC EC EC 00 ED ED ED 00 EE EE EE 00 EF EF EF 00 F0 F0 F0 00 F1 F1 F1 00 F2 F2 F2 00 F3 F3 F3 00 F4 F4 F4 00 F5 F5 F5 00 F6 F6 F6 00 F7 F7 F7 00 F8 F8 F8 00 F9 F9 F9 00 FA FA FA 00 FB FB FB 00 FC FC FC 00 FD FD FD 00 FE FE FE 00 FF FF FF 00

25

# MEME moments

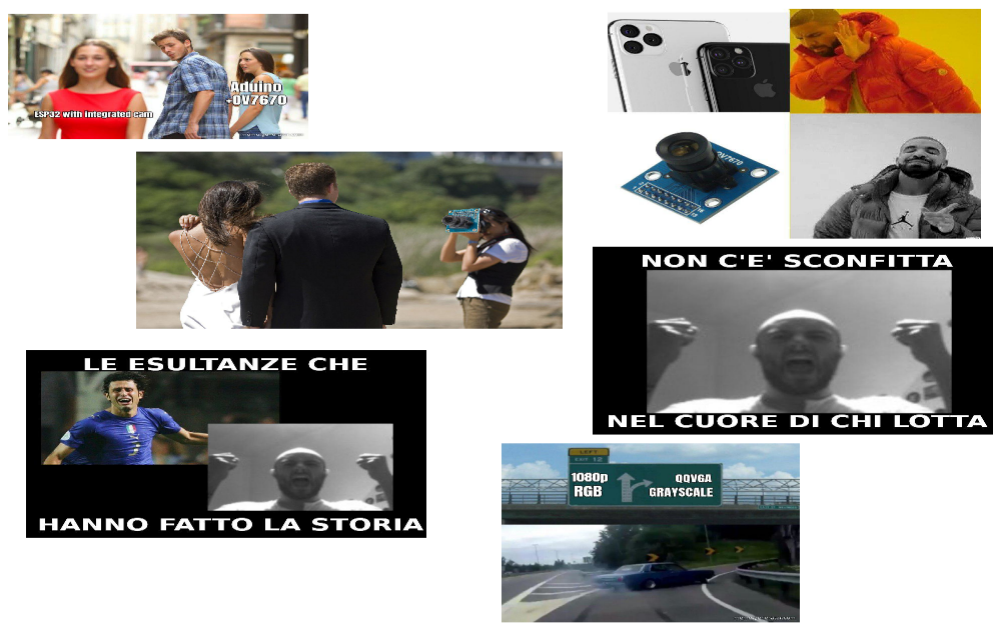
[picture p10: figure]

Per maggiori dettagli vedere allegato1.

26
